gerb-ster/Curtis-VC-ADSR/images/IMG_3557.jpeg

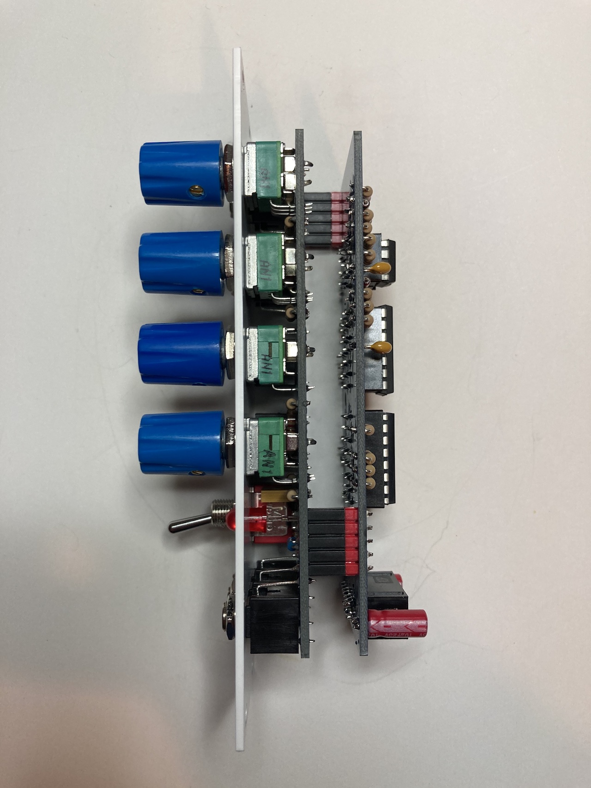
images/IMG_3557.jpeg
