gerb-ster/Curtis-VC-ADSR/images/IMG_3556.jpeg

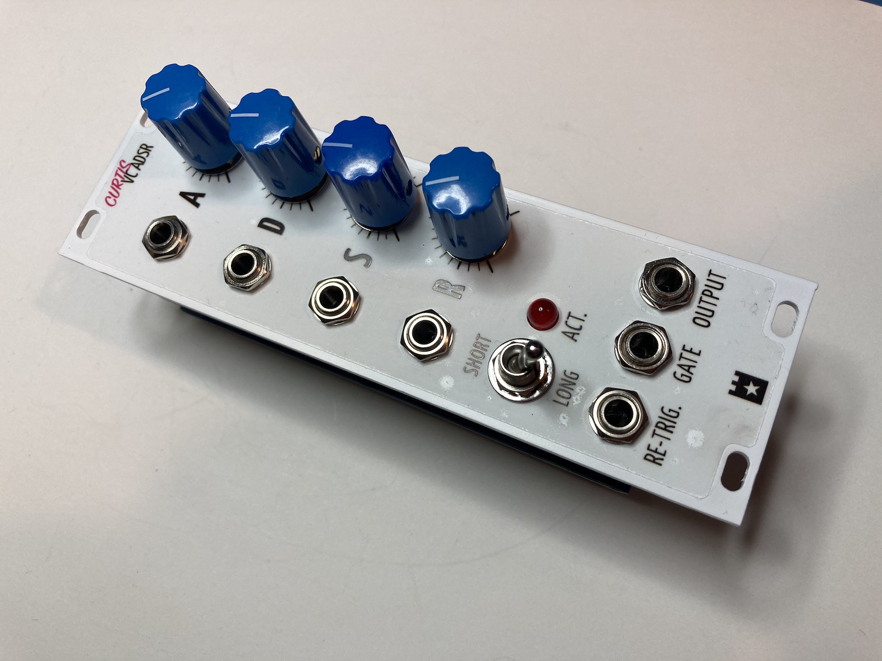
images/IMG_3556.jpeg
