gerb-ster/Curtis-VC-ADSR/README.md

# Curtis VC ADSR

A voltage controlled ADSR enveloppe generator based on the CEM 3310

## Status: Finished

- done: first schematic & board design
- done: breadboard and test
- done: design frontpanel
- done: order PCB and build prototype
