gerb-ster/Curtis-VC-ADSR/images/20190203_140620.bmp

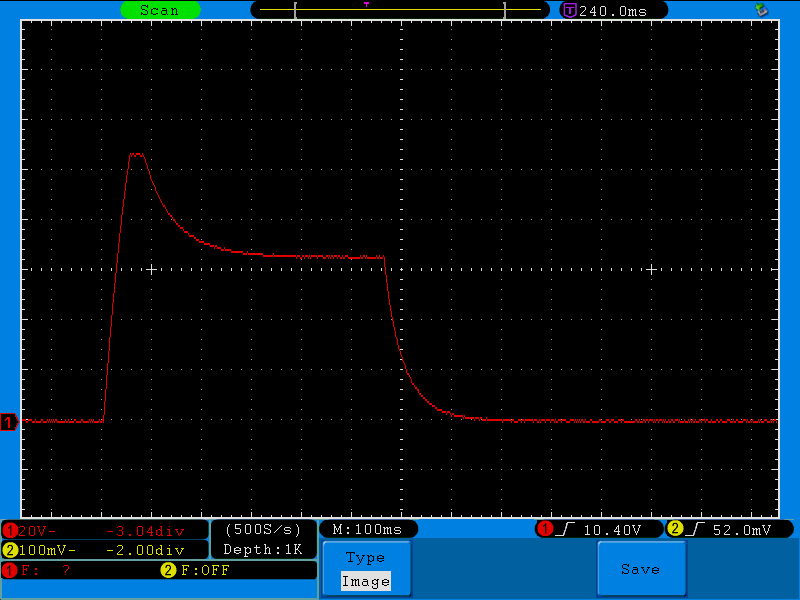
images/20190203_140620.bmp
