gerb-ster/Curtis-VC-ADSR/images/20190203_140802.bmp

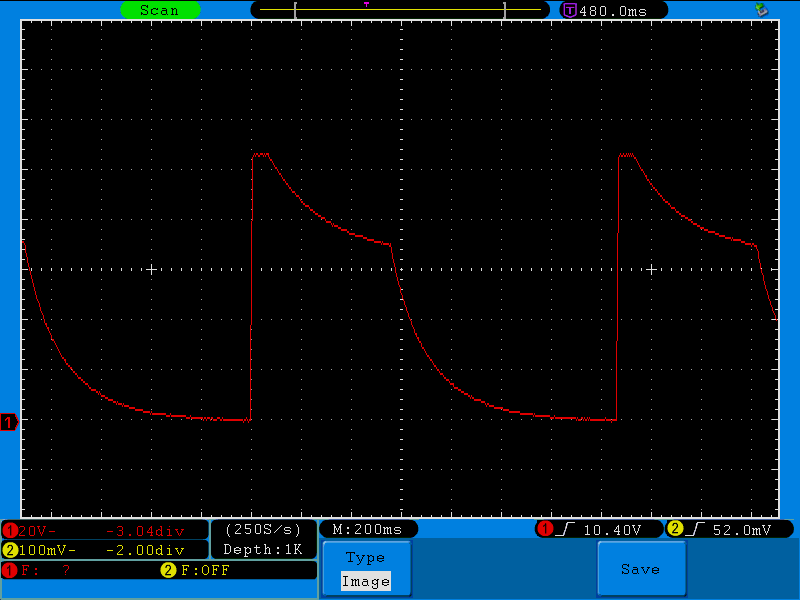
images/20190203_140802.bmp
