gerb-ster/Curtis-VC-ADSR/images/IMG_3555.jpeg

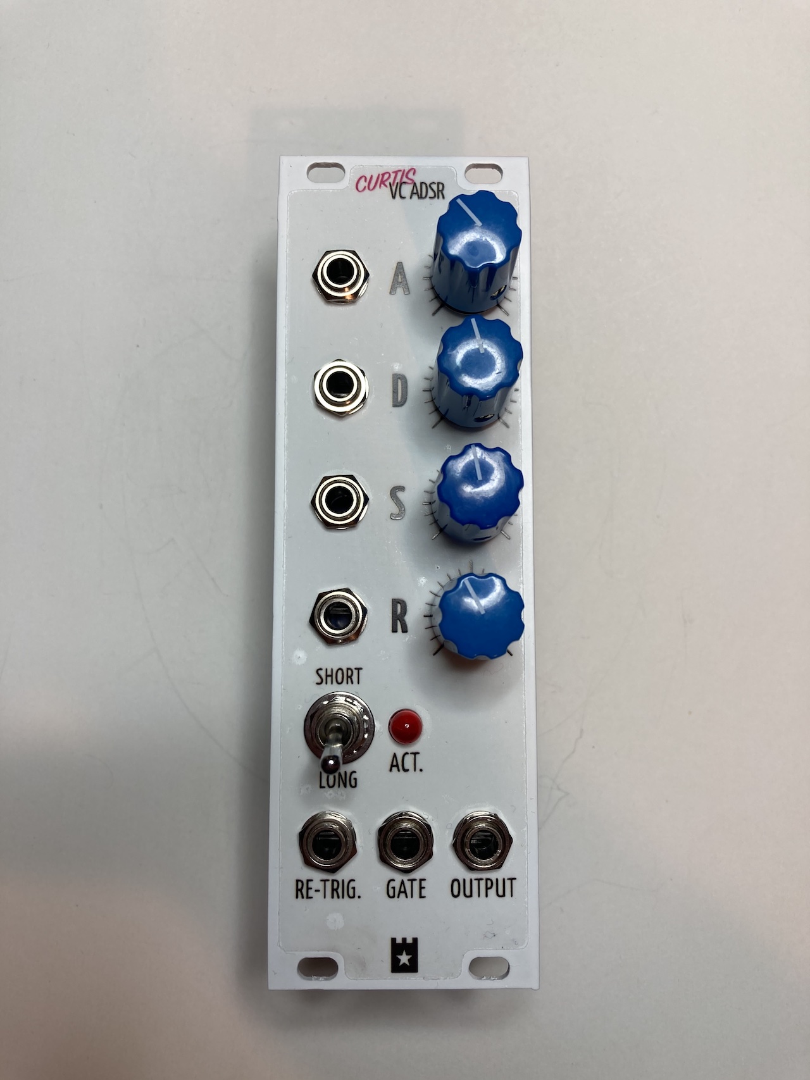
images/IMG_3555.jpeg
