gerb-ster/Curtis-VC-ADSR/images/IMG_3558.jpeg

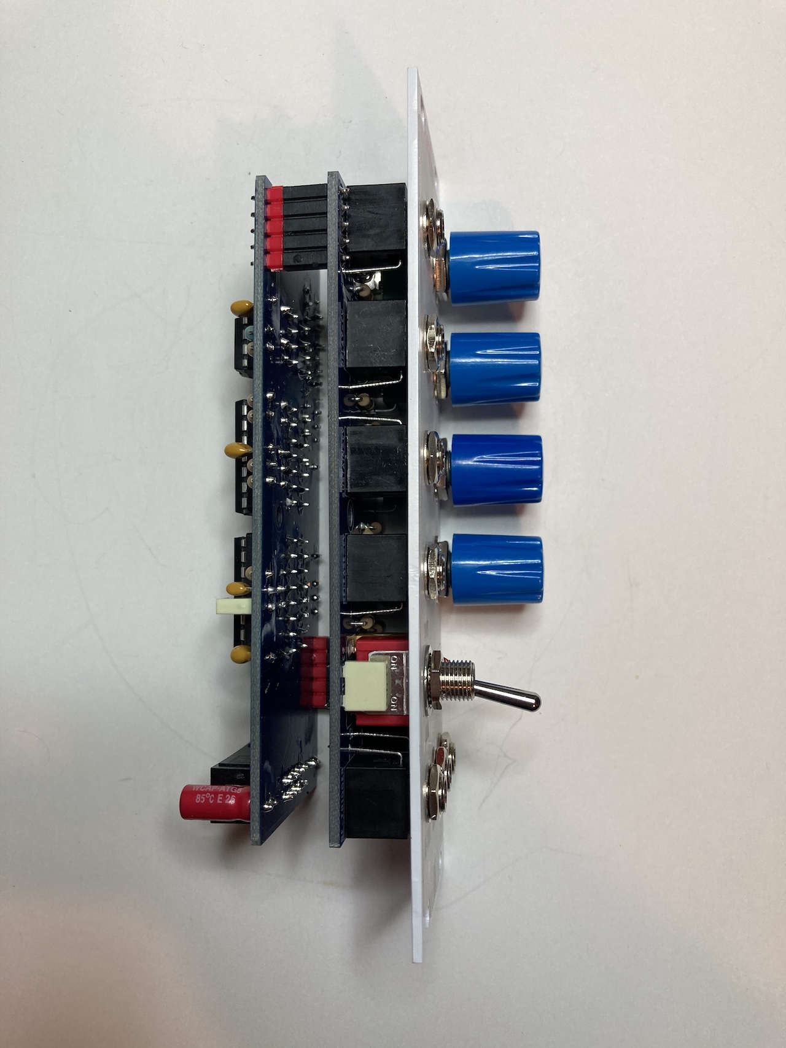
images/IMG_3558.jpeg
