gerb-ster/Curtis-VC-ADSR/images/IMG_3559.jpeg

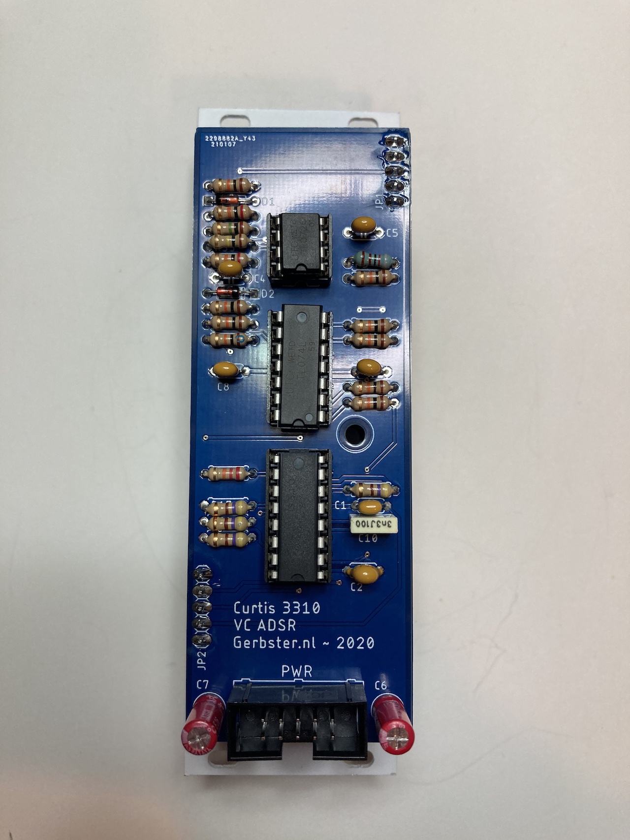
images/IMG_3559.jpeg
