gerb-ster/Curtis-VC-ADSR/images/IMG_3560.jpeg

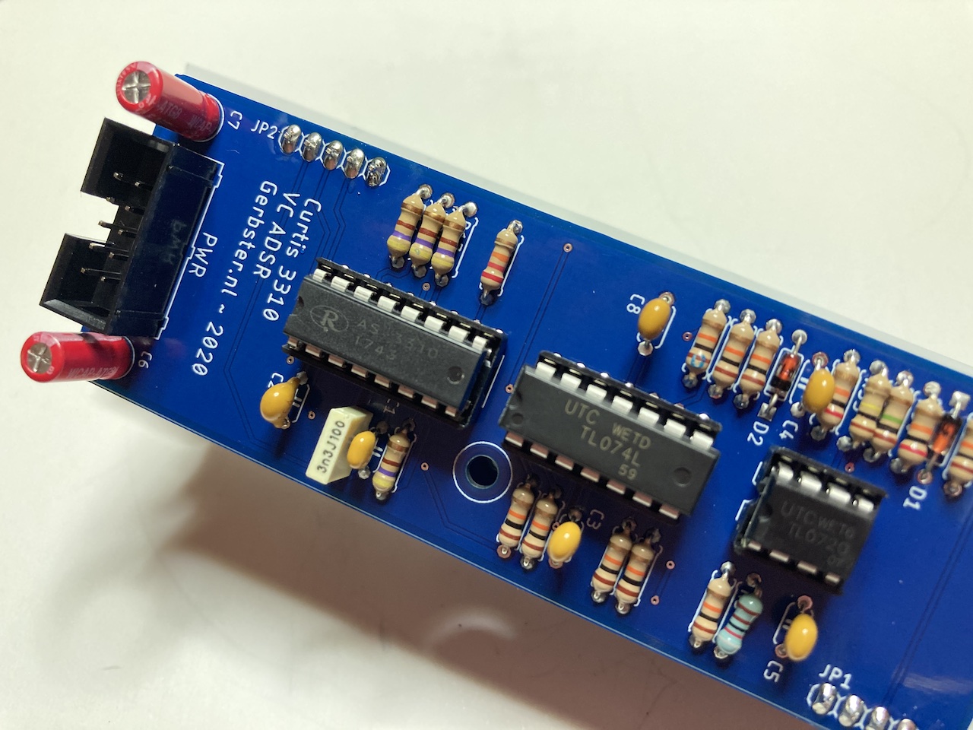
images/IMG_3560.jpeg
