gerb-ster/Curtis-VC-ADSR/images/IMG_3561.jpeg

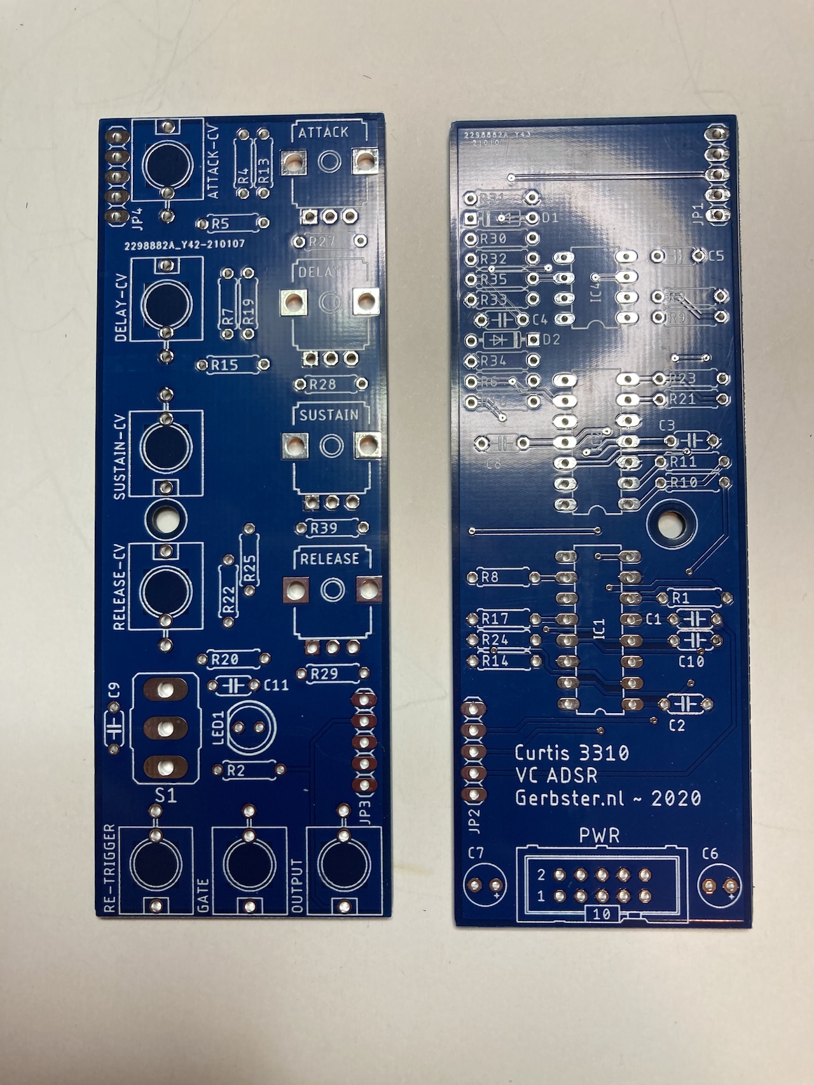
images/IMG_3561.jpeg
