gerb-ster/Curtis-VC-ADSR/images/IMG_3562.jpeg

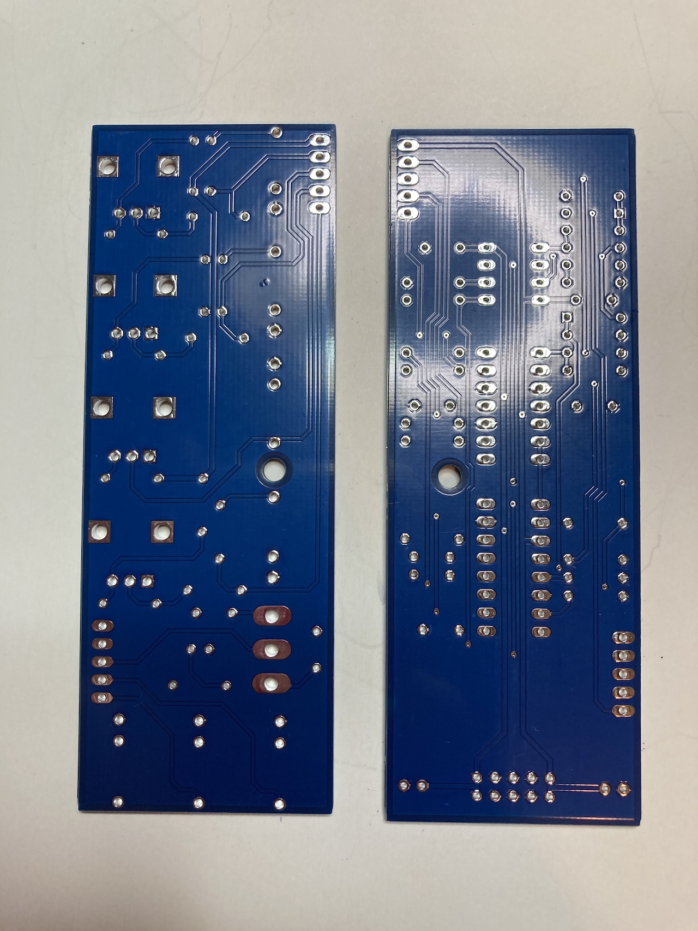
images/IMG_3562.jpeg
