gerb-ster/Curtis-VC-ADSR/faceplates/cem-adsr-io.dxf

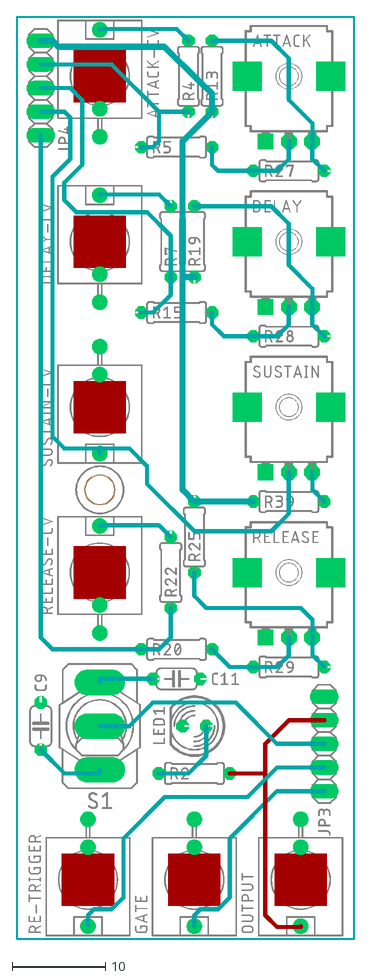
[picture p11: CAD file, 2021-05-01]
faceplates/cem-adsr-io.dxf
36.3 x 99.2
