gerb-ster/Curtis-VC-ADSR/schematics/Curtis-CV-ADSR-ioboard.pdf

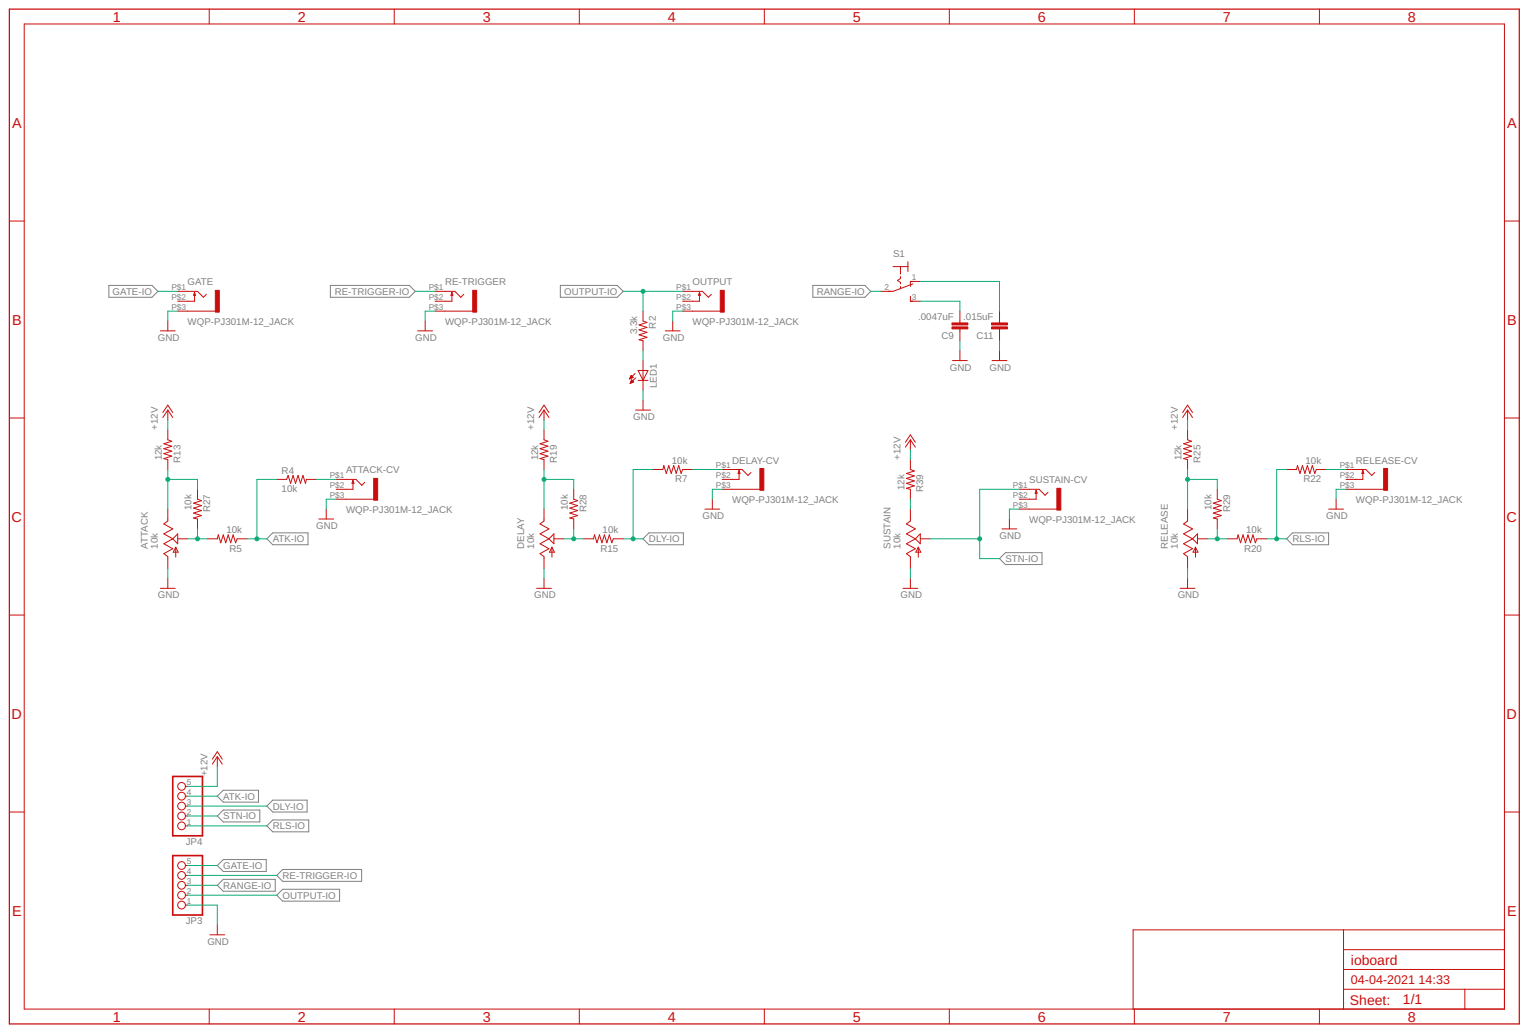
[picture p12: page 1]
