gerb-ster/Curtis-VC-ADSR/schematics/Curtis-CV-ADSR-mainboard.pdf

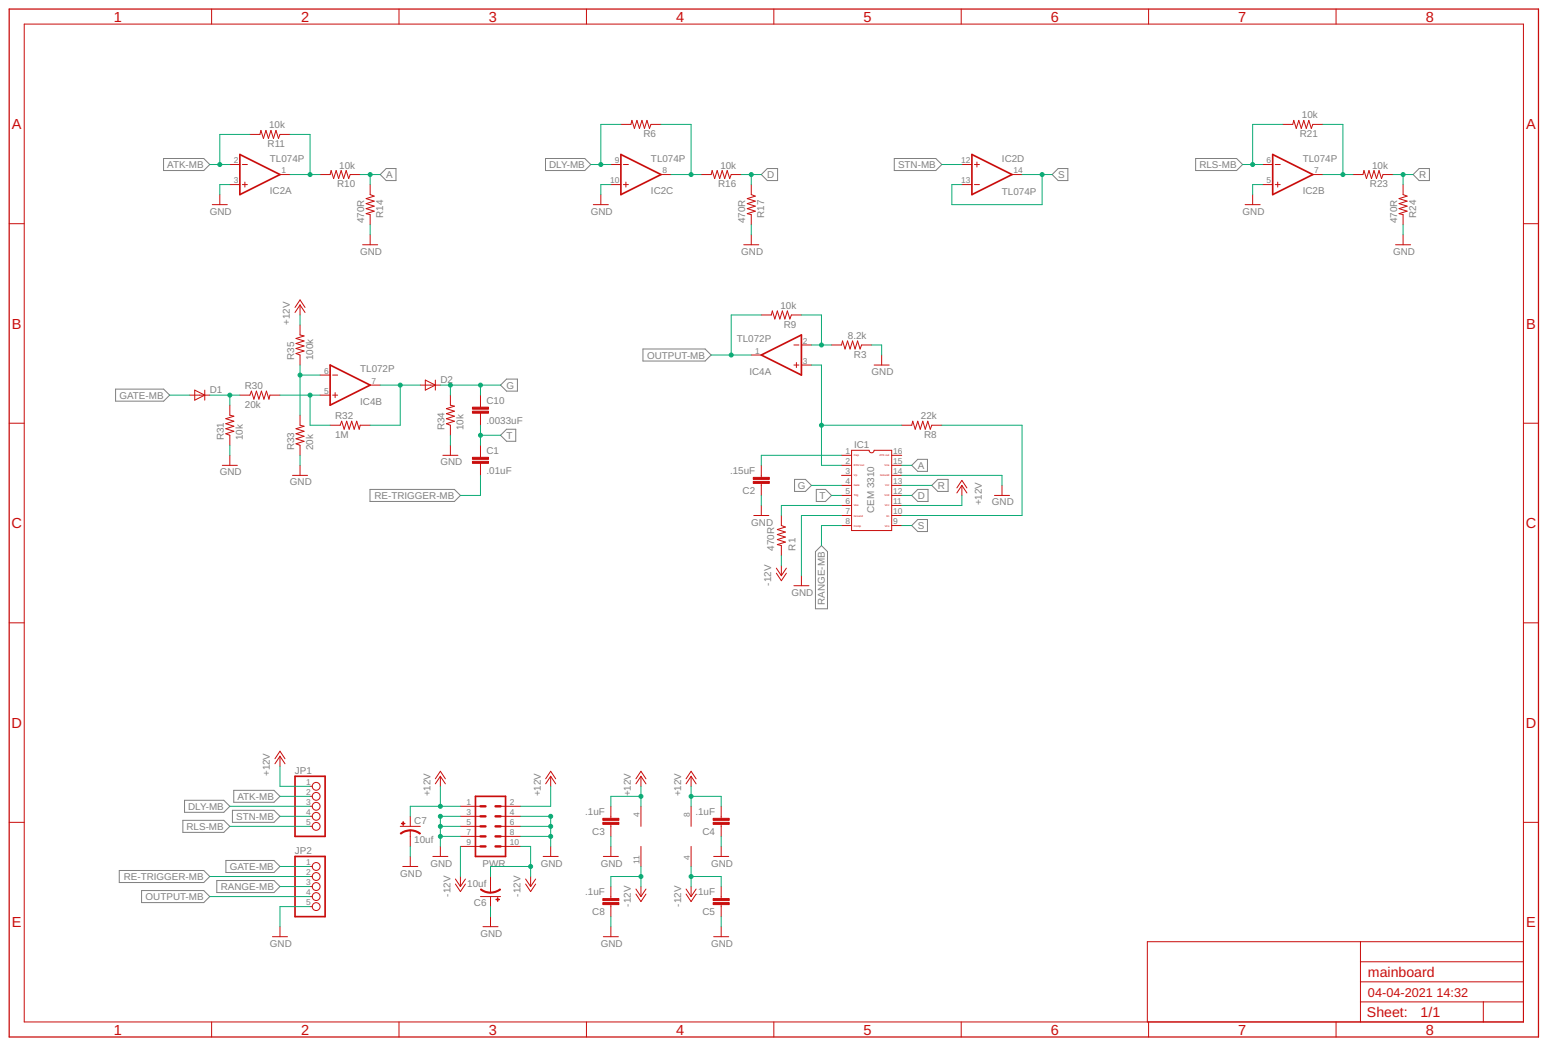
[picture p13: page 1]
