gerb-ster/Curtis-VC-ADSR/schematics/src/ioboard/ioboard.brd

## EAGLE design schematics/src/ioboard/ioboard.brd (2021-05-01)

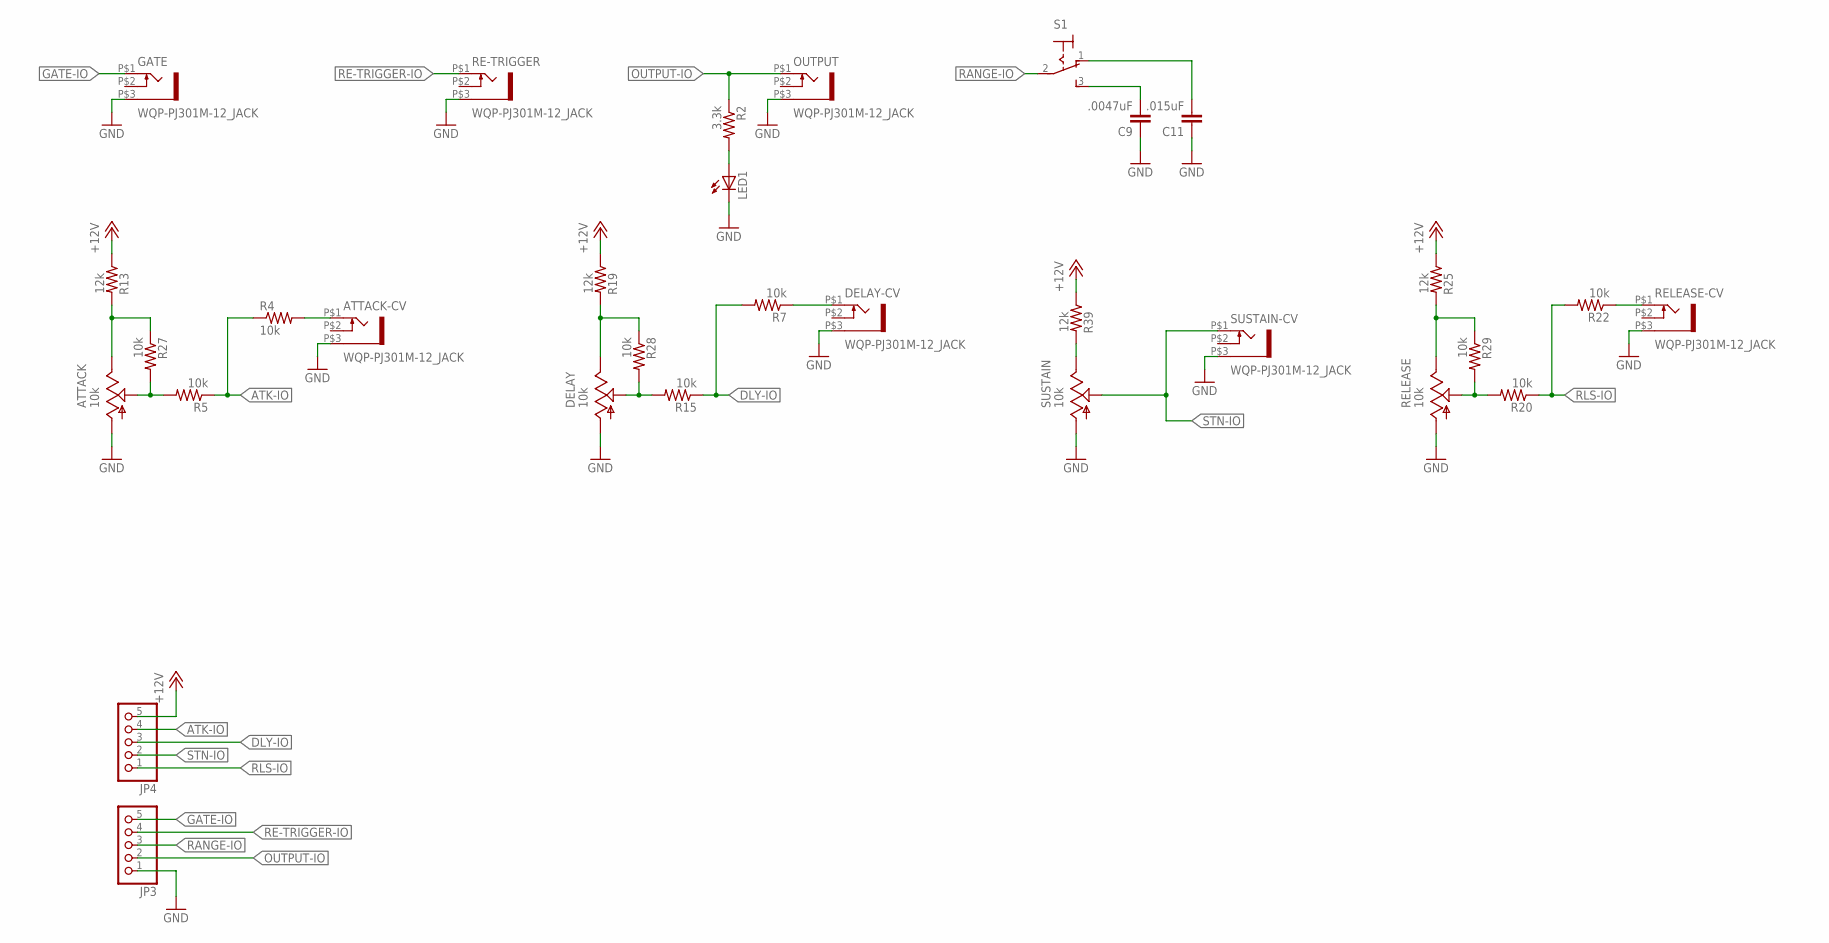
[picture p14: schematic ioboard.sch]

Parts:
ATTACK: 10k; EVUF
ATTACK-CV: WQP-PJ301M-12_JACK
C9: .0047uF; C050-024X044
C11: .015uF; C050-024X044
DELAY: 10k; EVUF
DELAY-CV: WQP-PJ301M-12_JACK
GATE: WQP-PJ301M-12_JACK
JP3, JP4: PINHD-1X5; 1X05
LED1: LED5MM
OUTPUT: WQP-PJ301M-12_JACK
R2: 3.3k; 0207/7
R4, R5, R7, R15, R20, R22, R27, R28, R29: 10k; 0207/7
R13, R19, R25, R39: 12k; 0207/7
RE-TRIGGER: WQP-PJ301M-12_JACK
RELEASE: 10k; EVUF
RELEASE-CV: WQP-PJ301M-12_JACK
S1: M9040P
SUSTAIN: 10k; EVUF
SUSTAIN-CV: WQP-PJ301M-12_JACK

Connections:
+12V: JP4.5, R13.1, R19.1, R25.1, R39.1
ATK-IO: JP4.4, R4.1, R5.1
ATTACK-CV: ATTACK-CV.P$1 (2), R4.2
DELAY-VC: DELAY-CV.P$1 (2), R7.1
DLY-IO: JP4.3, R7.2, R15.1
GATE-IO: GATE.P$1 (2), JP3.5
GND: ATTACK.1 (A), ATTACK-CV.P$3 (1), C9.1, C11.1, DELAY.1 (A), DELAY-CV.P$3 (1), GATE.P$3 (1), JP3.1, LED1.K (C), OUTPUT.P$3 (1), RE-TRIGGER.P$3 (1), RELEASE.1 (A), RELEASE-CV.P$3 (1), SUSTAIN.1 (A), SUSTAIN-CV.P$3 (1)
unnamed: C9.2, S1.3 (S)
unnamed: C11.2, S1.1 (O)
unnamed: ATTACK.2 (S), R5.2, R27.2
unnamed: ATTACK.3 (E), R13.2, R27.1
unnamed: DELAY.3 (E), R19.2, R28.1
unnamed: DELAY.2 (S), R15.2, R28.2
unnamed: R20.2, R29.2, RELEASE.2 (S)
unnamed: R25.2, R29.1, RELEASE.3 (E)
unnamed: LED1.A, R2.2
unnamed: R39.2, SUSTAIN.3 (E)
OUTPUT-IO: JP3.2, OUTPUT.P$1 (2), R2.1
RANGE-IO: JP3.3, S1.2
RE-TRIGGER-IO: JP3.4, RE-TRIGGER.P$1 (2)
RELEASE-CV: R22.1, RELEASE-CV.P$1 (2)
RLS-IO: JP4.1, R20.1, R22.2
STN-IO: JP4.2, SUSTAIN.2 (S), SUSTAIN-CV.P$1 (2)

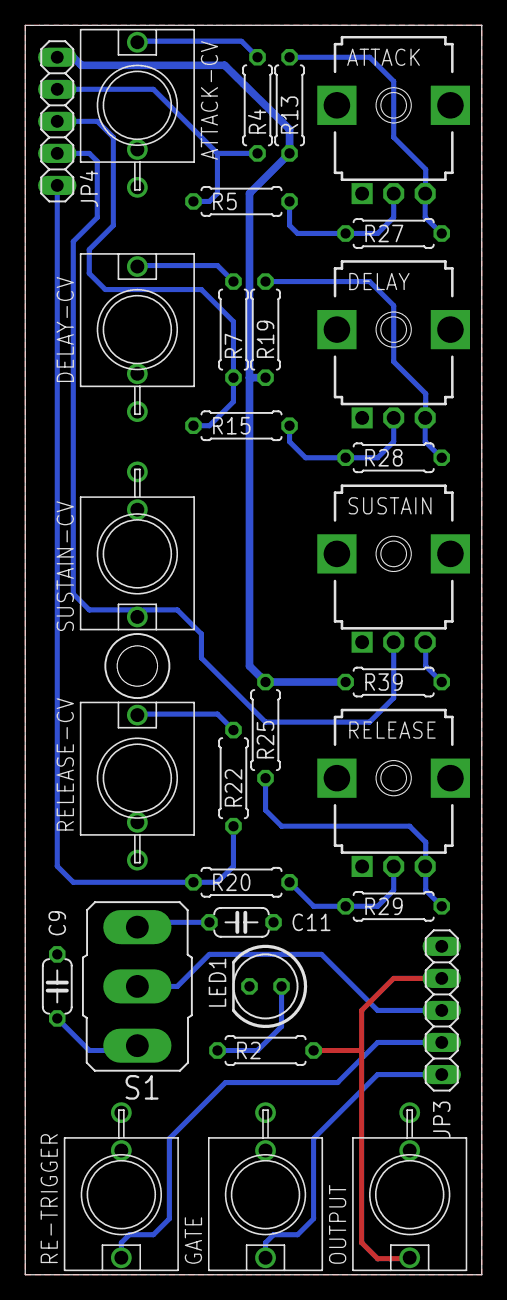
[picture p15: board ioboard.brd from above]

Board: 2 copper layers, 36.2 x 99.1 mm, 31 parts (0 on the bottom side), 23 nets.
