gerb-ster/Curtis-VC-ADSR/schematics/src/mainboard/mainboard.brd

## EAGLE design schematics/src/mainboard/mainboard.brd (2021-05-01)

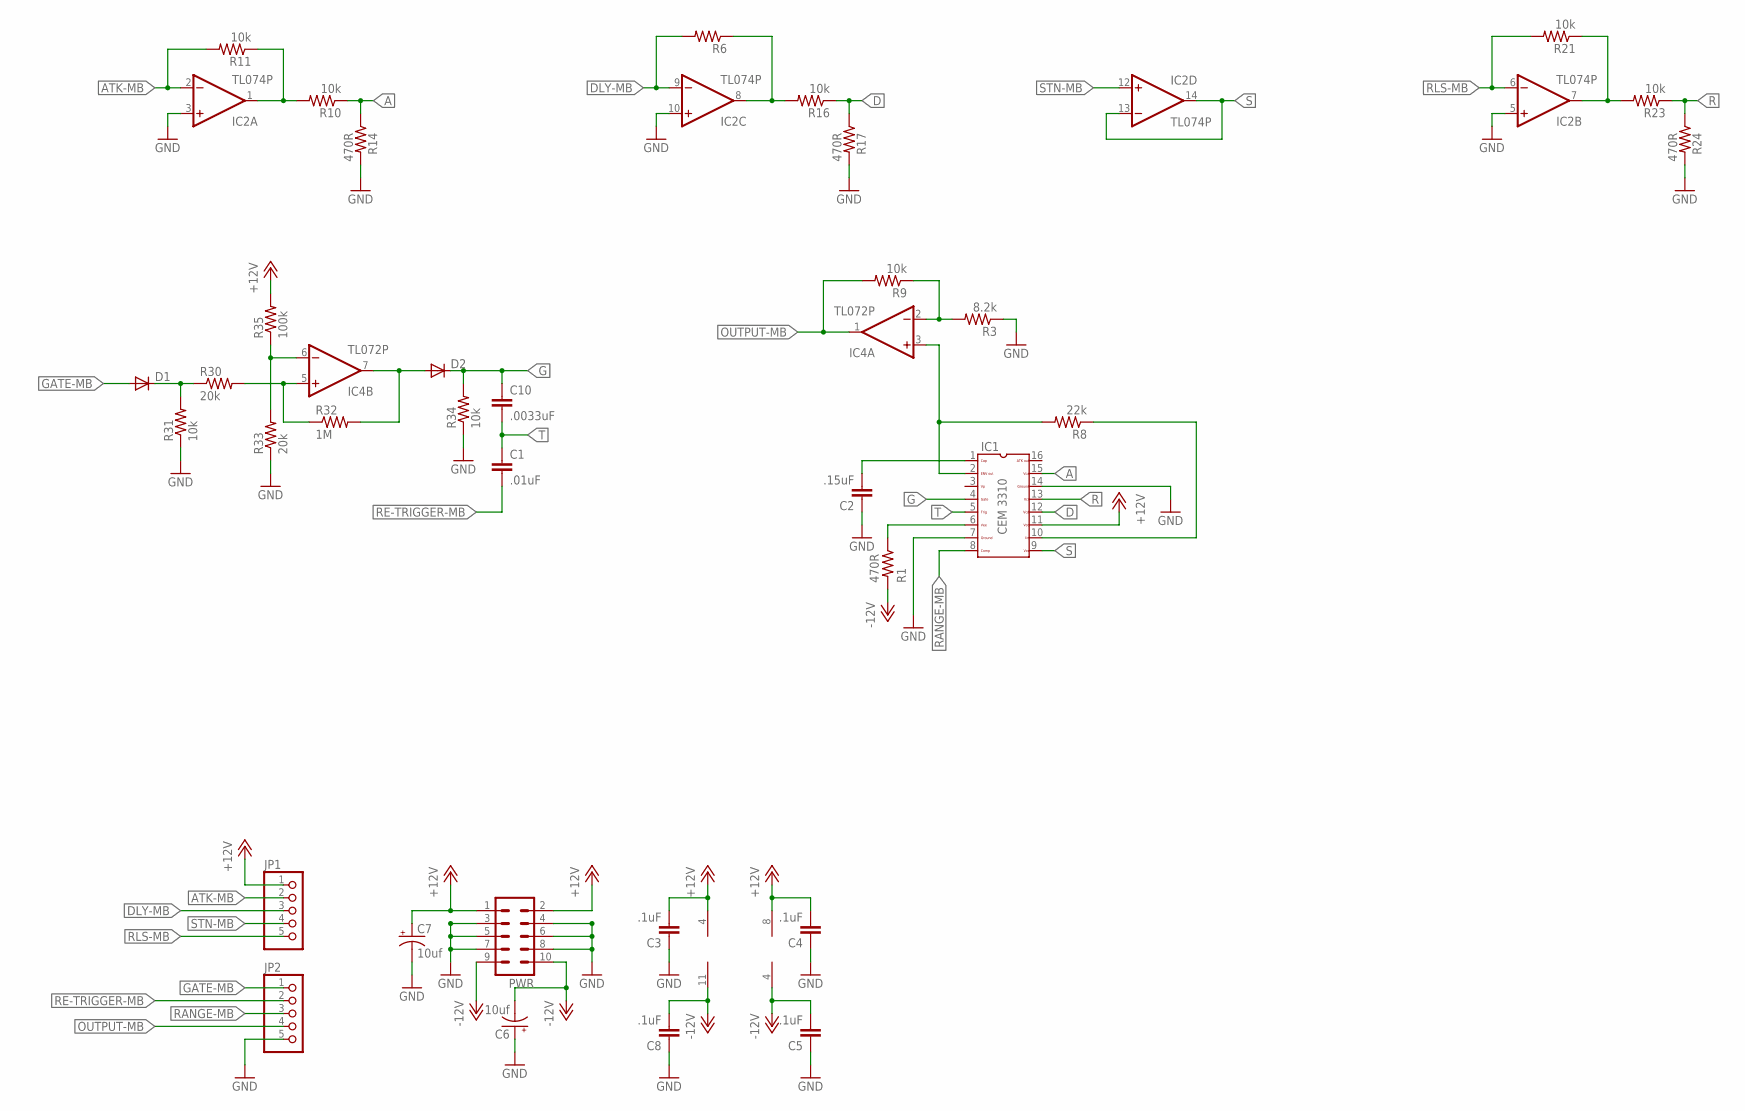
[picture p16: schematic mainboard.sch]

Parts:
C1: .01uF; C050-024X044
C2: .15uF; C050-024X044
C3, C4, C5, C8: .1uF; C050-024X044
C6, C7: 10uf; E2,5-5
C10: .0033uF; C050-024X044
D1, D2: 1N4148DO35-7; DO35-7
IC1: CEM3310; DIL16
IC2: TL074P; DIL14
IC4: TL072P; DIL08
JP1, JP2: PINHD-1X5; 1X05
PWR: ML10
R1, R14, R17, R24: 470R; 0207/7
R3: 8.2k; 0207/7
R6, R9, R10, R11, R16, R21, R23, R31, R34: 10k; 0207/7
R8: 22k; 0207/7
R30, R33: 20k; 0207/7
R32: 1M; 0207/7
R35: 100k; 0207/7

Connections:
+12V: C3.2, C4.2, C7.+, IC1.11, IC2.4 (V+), IC4.8 (V+), JP1.1, PWR.1, PWR.2, R35.2
-12V: C5.2, C6.-, C8.2, IC2.11 (V-), IC4.4 (V-), PWR.9, PWR.10, R1.2
A: IC1.15, R10.1, R14.1
ATK-MB: IC2.2 (-IN), JP1.2, R11.2
D: IC1.12, R16.1, R17.1
DLY-MB: IC2.9 (-IN), JP1.3, R6.2
G: C10.1, D2.C, IC1.4, R34.2
GATE-MB: D1.A, JP2.1
GND: C2.1, C3.1, C4.1, C5.1, C6.+, C7.-, C8.1, IC1.7, IC1.14, IC2.3 (+IN), IC2.5 (+IN), IC2.10 (+IN), JP2.5, PWR.3, PWR.4, PWR.5, PWR.6, PWR.7, PWR.8, R3.1, R14.2, R17.2, R24.2, R31.1, R33.1, R34.1
unnamed: IC1.6, R1.1
unnamed: C2.2, IC1.1
unnamed: IC2.1 (OUT), R10.2, R11.1
unnamed: D1.C, R30.1, R31.2
unnamed: IC2.8 (OUT), R6.1, R16.2
unnamed: IC1.2, IC4.3 (+IN), R8.2
unnamed: IC2.7 (OUT), R21.1, R23.2
unnamed: IC4.5 (+IN), R30.2, R32.1
unnamed: IC1.10, R8.1
unnamed: IC4.2 (-IN), R3.2, R9.1
unnamed: D2.A, IC4.7 (OUT), R32.2
unnamed: IC4.6 (-IN), R33.2, R35.1
OUTPUT-MB: IC4.1 (OUT), JP2.4, R9.2
R: IC1.13, R23.1, R24.1
RANGE-MB: IC1.8, JP2.3
RE-TRIGGER-MB: C1.2, JP2.2
RLS-MB: IC2.6 (-IN), JP1.5, R21.2
S: IC1.9, IC2.13 (-IN), IC2.14 (OUT)
STN-MB: IC2.12 (+IN), JP1.4
T: C1.1, C10.2, IC1.5

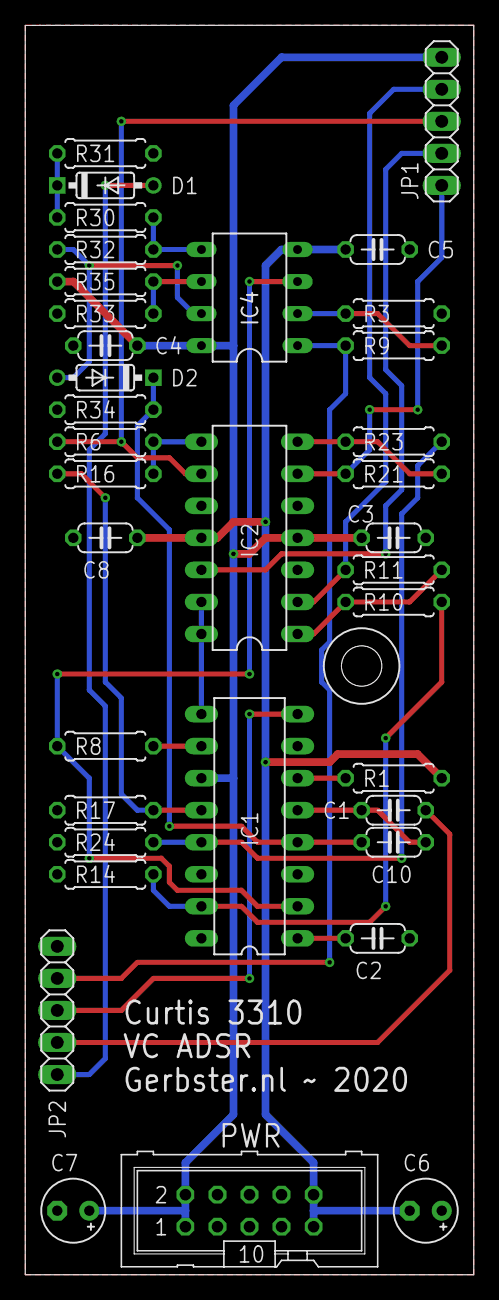
[picture p17: board mainboard.brd from above]

Board: 2 copper layers, 35.6 x 99.1 mm, 36 parts (0 on the bottom side), 29 nets.
