gerb-ster/Curtis-VC-ADSR/CHANGELOG.md

# Changelog

All notable changes to this project will be documented in this file.

The format is based on [Keep a Changelog](https://keepachangelog.com/en/1.0.0/),
and this project adheres to [Semantic Versioning](https://semver.org/spec/v2.0.0.html).

## [1.0.0] - 2021-01-05

### Added

- Inintial repo setup
- Schematics
- Images
- Faceplates
