gerb-ster/Curtis-VC-ADSR/(threads)

Thread 1 (2021-11-04):

dxf of the front panel?

KeLaiFu, 2021-11-04:
would it be possible to get the .dxf for the front panel? Theres a .dxf in the frontplates folder but it appears to be the front PCB, not the panel itself.

Thanks!

KeLaiFu, 2021-11-04:
figured a work around, so problem solved. used the 'position relative to' in kicad to place drill holes where the footprints are, job done.

Thanks for your great modules, looking forward to finally utilising my 3310

Thread 2 (2022-09-14):

can't find CEM 3310

LegendaryTeacherLiu, 2022-09-14:
I can't buy IC1 “ CEM 3310 VCEG”, can I replace it with another model?

gerb-ster, 2022-09-14:
Yes, there is a drop-in replacement from AS, the AS3310.

https://www.alfarzpp.lv/eng/sc/AS3310.php
