gerb-ster/Curtis-VC-ADSR/(commit log)

2021-05-07 added files & Structure
    [Curtis-CV-ADSR-ioboard.GBL, Curtis-CV-ADSR-ioboard.GBO, Curtis-CV-ADSR-ioboard.GBP, Curtis-CV-ADSR-ioboard.GBS, Curtis-CV-ADSR-ioboard.GKO, Curtis-CV-ADSR-ioboard.GTL, Curtis-CV-ADSR-ioboard.GTO, Curtis-CV-ADSR-ioboard.GTP]
2021-08-06 Updated some schematics and docs
    [Curtis-CV-ADSR-ioboard.GBL, Curtis-CV-ADSR-ioboard.GBO, Curtis-CV-ADSR-ioboard.GBP, Curtis-CV-ADSR-ioboard.GBS, Curtis-CV-ADSR-ioboard.GKO, Curtis-CV-ADSR-ioboard.GTL, Curtis-CV-ADSR-ioboard.GTO, Curtis-CV-ADSR-ioboard.GTP]
2021-08-10 Fixed some bugs and updated documentation
    [Curtis-CV-ADSR-ioboard.XLN, Curtis-CV-ADSR-mainboard.XLN, gerber_job.gbrjob]
2022-04-20 Some updates & bugfixes
    [Curtis-CV-ADSR-ioboard.XLN, Curtis-CV-ADSR-mainboard.XLN, gerber_job.gbrjob]
2022-04-22 Fixed schematics & descriptions
    [Curtis-CV-ADSR-ioboard.XLN, Curtis-CV-ADSR-mainboard.XLN, gerber_job.gbrjob]
2022-05-17 Updated Firmware
    [Curtis-CV-ADSR-ioboard.XLN, Curtis-CV-ADSR-mainboard.XLN, gerber_job.gbrjob]
2022-05-18 Updated Faceplates
    [Curtis-CV-ADSR-ioboard.XLN, Curtis-CV-ADSR-mainboard.XLN, gerber_job.gbrjob]
2022-05-18 Fixed issues
    [Curtis-CV-ADSR-ioboard.XLN, Curtis-CV-ADSR-mainboard.XLN, gerber_job.gbrjob]
2022-05-21 Fixed schematics
    [Curtis-CV-ADSR-ioboard.XLN, Curtis-CV-ADSR-mainboard.XLN, gerber_job.gbrjob]
2022-05-28 General updates
    [Curtis-CV-ADSR-ioboard.GKO, Curtis-CV-ADSR-mainboard.GKO, copper_bottom.gbr, copper_top.gbr, drills.xln, gerber_job.gbrjob, profile.gbr, silkscreen_bottom.gbr]
